TortaCubana707/FROSTER/evidencias/E1/04_LCD_WiFi_y_OLED_nivel.jpg

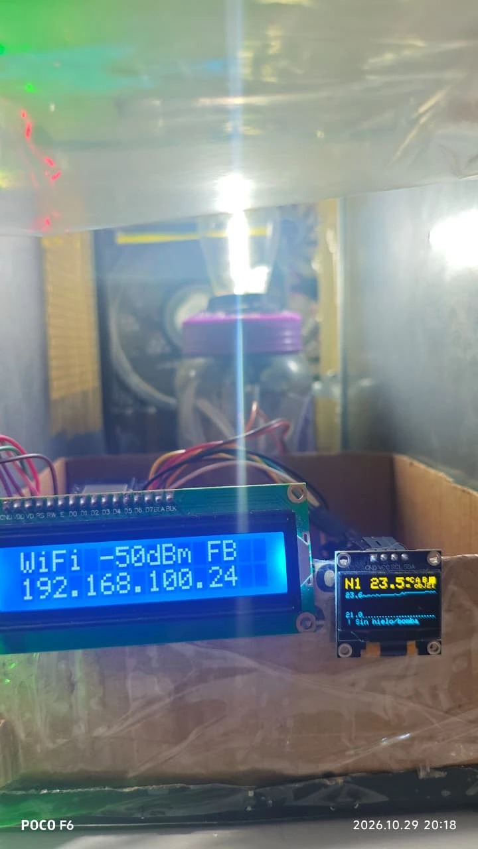
evidencias/E1/04_LCD_WiFi_y_OLED_nivel.jpg
