TortaCubana707/FROSTER/evidencias/E1/01_fuente_y_conexion_a_la_toma.jpg

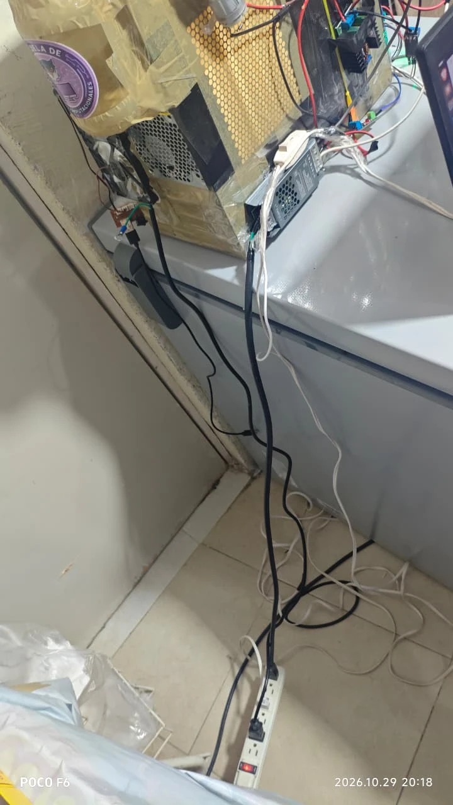
evidencias/E1/01_fuente_y_conexion_a_la_toma.jpg
