TortaCubana707/FROSTER/diagramas/FROSTER_diagramas_conexiones.pdf

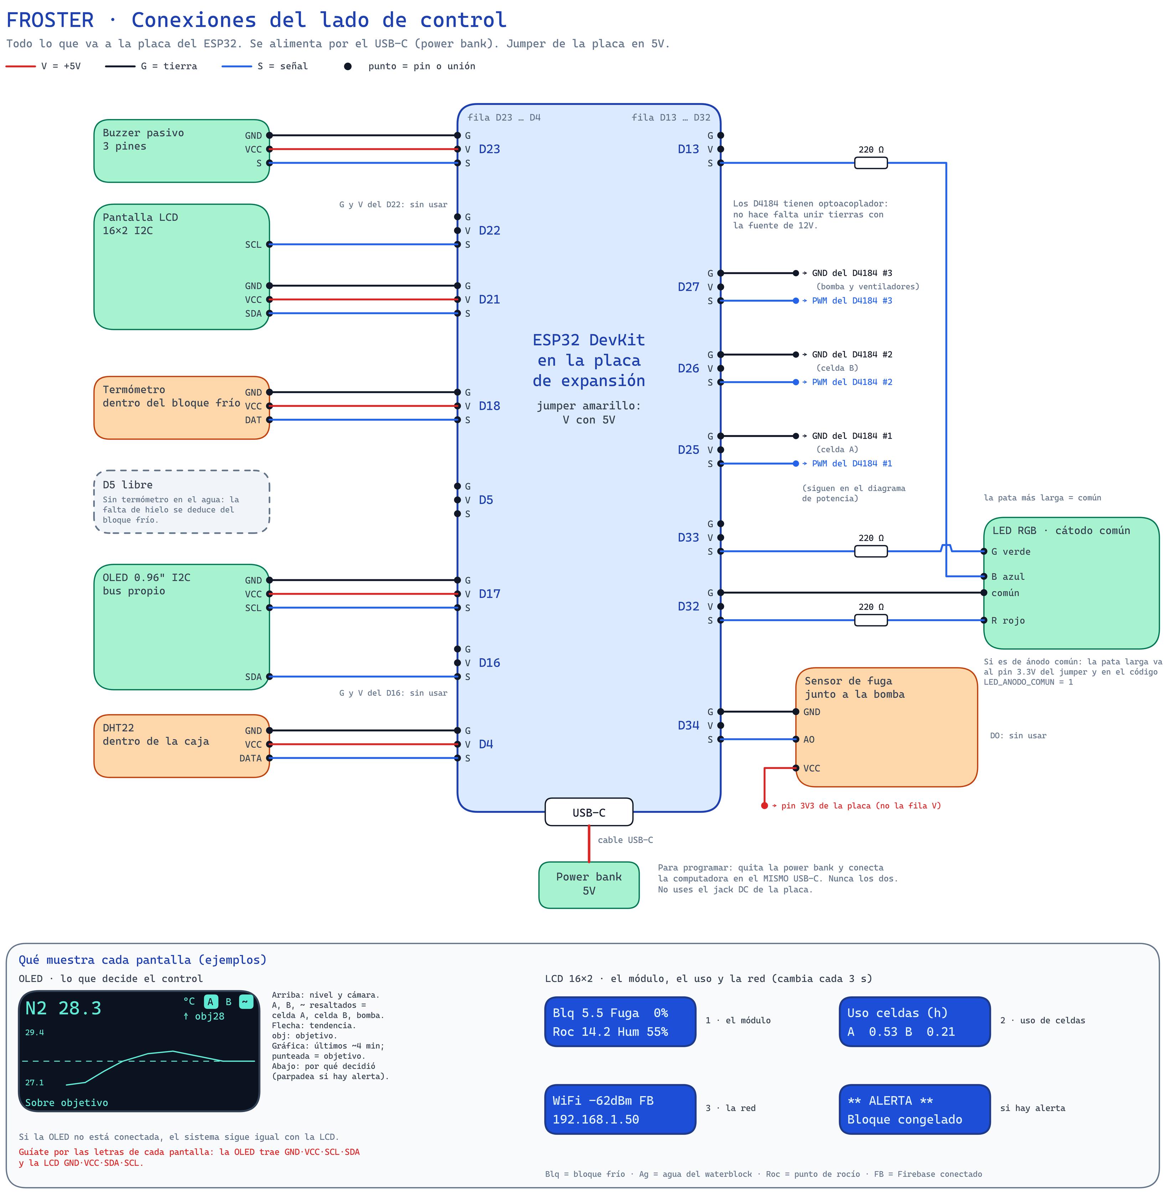
[picture p3: page 1]
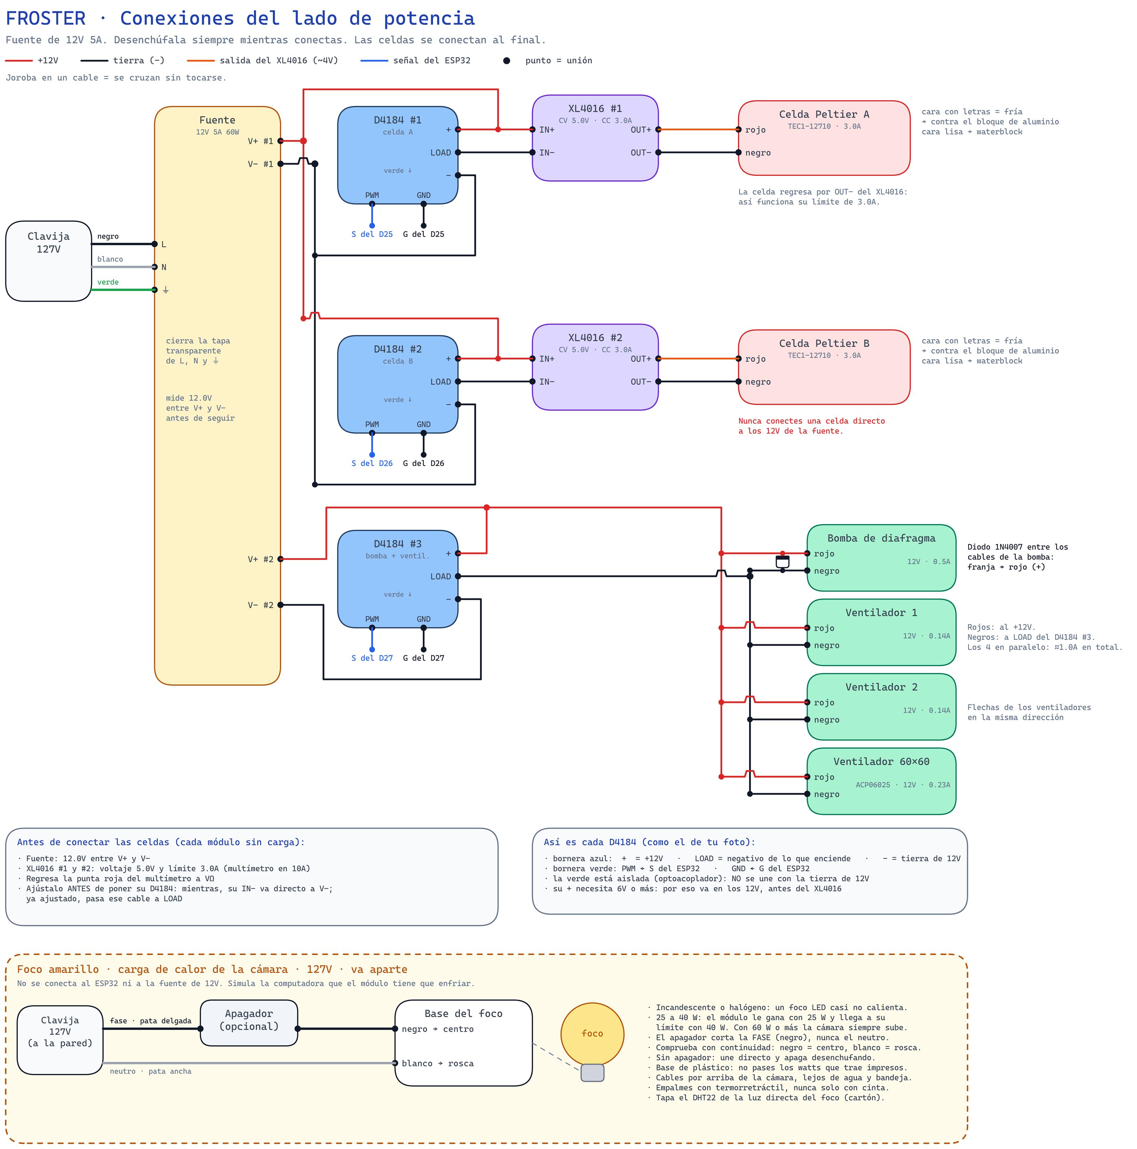
[picture p4: page 2]
