TortaCubana707/FROSTER/evidencias/E1/02_modulo_D4184_XL4016_y_LED_RGB.jpg

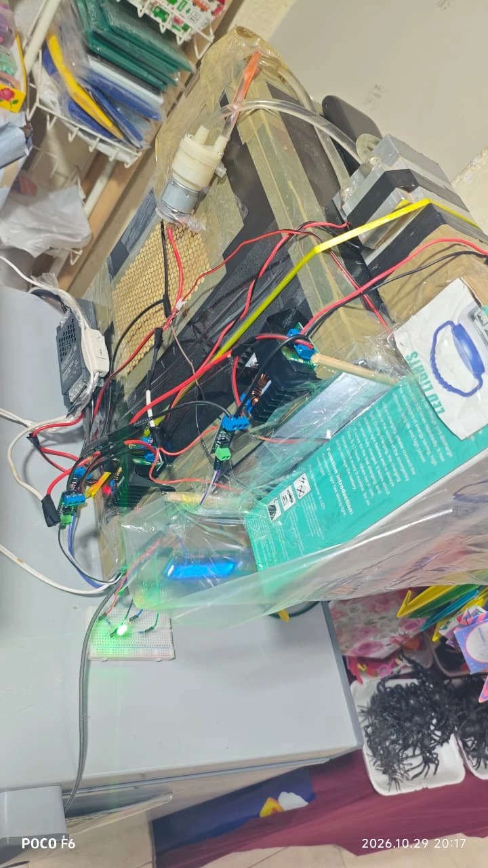
evidencias/E1/02_modulo_D4184_XL4016_y_LED_RGB.jpg
