TortaCubana707/FROSTER/evidencias/E1/03_prototipo_completo.jpg

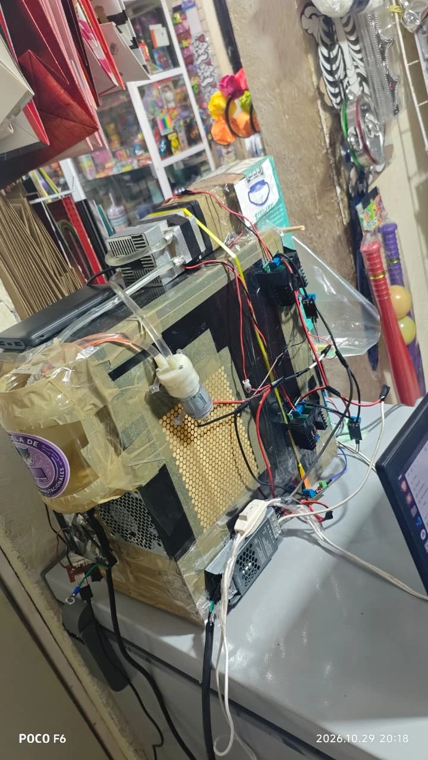
evidencias/E1/03_prototipo_completo.jpg
