TortaCubana707/FROSTER/firmware/FROSTER_Control/secretos.ejemplo.h

// Credenciales de Firebase del ESP32. Este archivo es la plantilla; el real (secretos.h) NO se sube a GitHub (.gitignore).
// Para compilar en otra computadora: copiar secretos.ejemplo.h como secretos.h y llenarlo.
#pragma once
#define API_KEY ""        // Firebase > Configuración del proyecto > Clave de API web
#define DATABASE_URL ""   // https://<proyecto>-default-rtdb.firebaseio.com
#define USER_EMAIL ""     // usuario creado en Firebase Authentication para la placa
#define USER_PASSWORD ""
