TortaCubana707/FROSTER/(commit log)

2026-10-30 feat: prototipo FROSTER con firmware ESP32, pruebas, diagramas y evidencias E1
2026-10-30 docs: video de 1 minuto de la E1 con animación, fotos reales y voz
2026-11-08 refactor: firmware en pestañas, sin delay(), reconexión WiFi, PWM de ventilación y calibración
2026-11-08 feat: sensor de fuga junto a la bomba y justificación de las adaptaciones al Proyecto 1
2026-11-08 feat: activar y calibrar el sensor de fuga; lectura del ADC en el Monitor Serie
